GeorgeFound1/Autonomous-Mobile-Manipulator-Robot-on-ESP32/docs/images/schematic.pdf

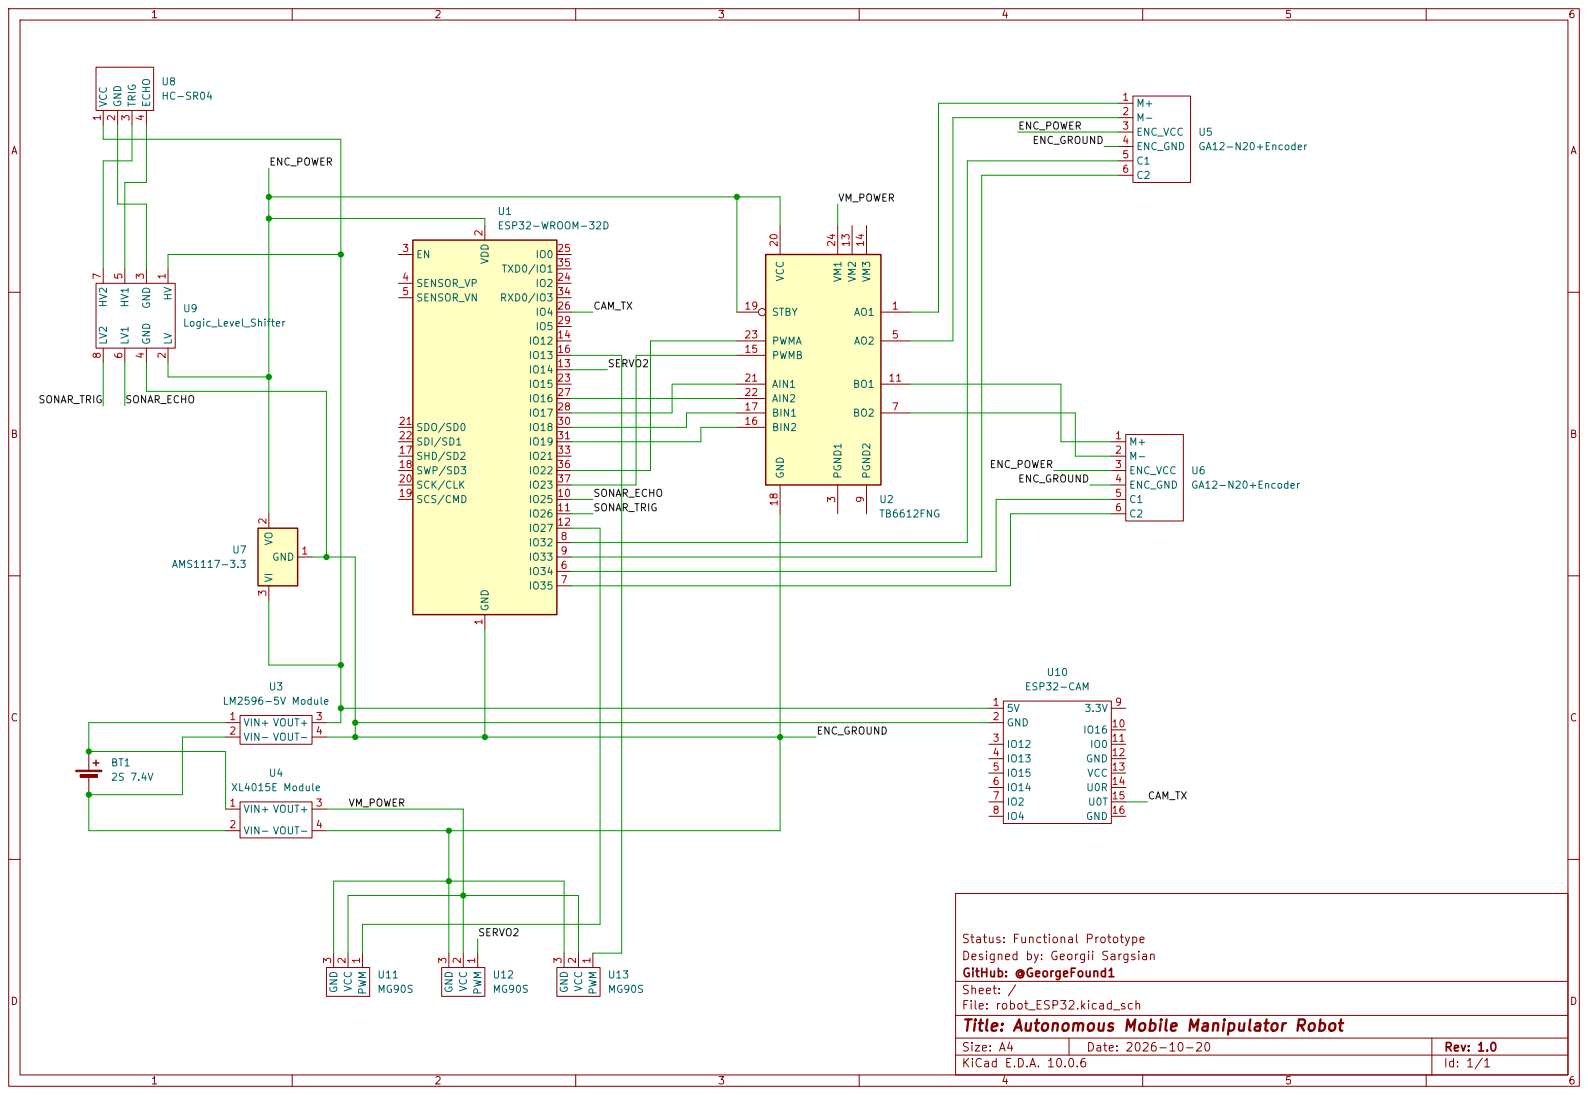
[picture p3: page 1]

Status: Functional Prototype
Designed by: Georgii Sargsian
GitHub: @GeorgeFound1
Sheet: /
File: robot_ESP32.kicad_sch
Title: Autonomous Mobile Manipulator Robot

Size: A4 | Rev: 1.0
KiCad E.D.A. 10.0.6 | Id: 1/1
