GeorgeFound1/Autonomous-Mobile-Manipulator-Robot-on-ESP32/vision_board/src/camera_config.hpp

#ifndef CONFIG_HPP
#define CONFIG_HPP

// ESP32-CAM camera pins
#define PWDN_GPIO_NUM     32
#define RESET_GPIO_NUM    -1
#define XCLK_GPIO_NUM      0
#define SIOD_GPIO_NUM     26
#define SIOC_GPIO_NUM     27

#define Y9_GPIO_NUM       35
#define Y8_GPIO_NUM       34
#define Y7_GPIO_NUM       39
#define Y6_GPIO_NUM       36
#define Y5_GPIO_NUM       21
#define Y4_GPIO_NUM       19
#define Y3_GPIO_NUM       18
#define Y2_GPIO_NUM        5
#define VSYNC_GPIO_NUM    25
#define HREF_GPIO_NUM     23
#define PCLK_GPIO_NUM     22

// UART TX pin to robot
#define TX_PIN 14

bool initCamera();

#endif
