GeorgeFound1/Autonomous-Mobile-Manipulator-Robot-on-ESP32/motor_board/src/protocol.hpp

#ifndef PROTOCOL_HPP
#define PROTOCOL_HPP

#include <Arduino.h>
#include "target_search.hpp"

// Camera packet structure, packed for binary transfer
#pragma pack(push, 1)
struct CameraData {
    uint8_t startByte;  
    bool detected;  
    float distance;
    float angle;
    uint8_t checksum;
};
#pragma pack(pop)

// Start byte of camera packet
const uint8_t START_MARKER = 0xAA;

// Read packet from UART and check it
bool dataUnpackage(CameraData *packet);
void dataCopy(CameraData *data, TargetData *target);
// Calculate XOR checksum
uint8_t calculateChecksum(const uint8_t* data, size_t length);

#endif
