GeorgeFound1/Autonomous-Mobile-Manipulator-Robot-on-ESP32/vision_board/src/camera_config.cpp

#include "Arduino.h"
#include "esp_camera.h"
#include "camera_config.hpp"

bool initCamera() {
    camera_config_t config;
    
    config.ledc_channel = LEDC_CHANNEL_0;
    config.ledc_timer = LEDC_TIMER_0;
    config.pin_d0 = Y2_GPIO_NUM;
    config.pin_d1 = Y3_GPIO_NUM;
    config.pin_d2 = Y4_GPIO_NUM;
    config.pin_d3 = Y5_GPIO_NUM;
    config.pin_d4 = Y6_GPIO_NUM;
    config.pin_d5 = Y7_GPIO_NUM;
    config.pin_d6 = Y8_GPIO_NUM;
    config.pin_d7 = Y9_GPIO_NUM;
    config.pin_xclk = XCLK_GPIO_NUM;
    config.pin_sccb_sda = SIOD_GPIO_NUM;
    config.pin_sccb_scl = SIOC_GPIO_NUM;
    config.pin_pwdn = PWDN_GPIO_NUM;
    config.pin_reset = RESET_GPIO_NUM;
    config.pin_vsync = VSYNC_GPIO_NUM;
    config.pin_href = HREF_GPIO_NUM;
    config.pin_pclk = PCLK_GPIO_NUM;

    config.xclk_freq_hz = 20000000;
    
    config.pixel_format = PIXFORMAT_RGB565; 

    config.frame_size = FRAMESIZE_VGA;
    
    config.fb_count = 1;

    // Initialize camera driver
    esp_err_t err = esp_camera_init(&config);
    if (err != ESP_OK) {
        Serial.printf("Camera init failed with error 0x%x\n", err);
        return false;
    }

    // Discard first frames to stabilize camera
    for (int i = 0; i < 10; i++) {
        camera_fb_t * fb = esp_camera_fb_get();
        if (fb) esp_camera_fb_return(fb);
        delay(50);
    }

    // Disable auto image controls for stable color detection
    sensor_t * s = esp_camera_sensor_get();
    if (s) {

        s->set_gain_ctrl(s, 0);    // Disable auto image controls for stable color detection  
        s->set_exposure_ctrl(s, 0);   // Disable auto exposure
        s->set_whitebal(s, 0);      // Disable auto white balance
    }
    
    return true;
}
